semianalog/mod12003/README.txt

MOD12003  [[WIP]]
=================

Work in progress.

20V 3A power supply module for MOD1 series of modular power supplies.
