semianalog/mod12003/doc/main.pdf

OWNER’S AND SERVICE MANUAL | MOD12003

e MOD12003 is a standard-precision, 20 V, 3 A module for the MOD1 series of multi-output, modular power supplies. It uses a hybrid switching + linear architecture that achieves acceptable noise levels for most uses while also maintaining low power dissipation.

Table 1: Specications

Parameter | Value | Unit

Voltage

Full-scale output voltage | 20 | V
Output voltage resolution | 10 | mV
Output voltage tolerance | 0.5% ± 10 | mV
Minimum output-enabled voltage | 100 | mV

Current

Full-scale output current | 3 | A
Output current resolution | 2 | mA
Output current tolerance | 0.5% ± 2 | mA
Min. current limit, worst case | 10 | mA
Current sense dead zone, worst case | 0 – 10 | mA

Slew rate (soware programmable)

Max. rising slew rate (allow 2% + 15 mV overshoot) | 3.2 | V/ms
Max. rising slew rate (no overshoot) | 2.0 | V/ms
Falling slew time constant (rst-order RC) | 200 | ms

Overload

Max. forced pos. output voltage (passive) | 24 | V
Max. forced pos. output voltage (fuse blows) | 63 | V
Max. forced neg. output voltage (passive) | −0.3 | V
Max. forced neg. output voltage (fuse blows) | −63 | V
Fuse rupture capacity | 50 | A
On-board spare fuses (install with solder bridge) | 2
Programmable OVP (blows fuse if necessary) | 3 – 24 | V
OVP threshold resolution | 150 | mV
OVP threshold tolerance | 2% ± 50 | mV
z. No copyright claimed; Creative Commons Zero (https://creativecommons.org/publicdomain/zero/1.0/) where not possible. Wrien in 2015 by Chris Pavlina.

# Contents

Contents | i
1 eory of Operation | 1
A Full Schematics | 5
B MOD1 loop interface | 12
C License | 13

i

# List of Figures

1.1 | Block diagram | | 2
1.2 | Linear regulator partial: control amplier | | 3
1.3 | Linear regulator partial: output amplier | | 3
1.4 | Voltage sense amplier | | 3
1.5 | Current sense amplier | | 3
1.6 | Output protection | | 4

# List of Tables

1 | Specications | | i

ii

# Chapter 1

# eory of Operation

### 1.1 Introduction

is chapter describes the operation of the MOD12003 , ranging from a broad overview to detailed sections on subcircuits and soware routines.

Block Diagram

Figure 1.1 contains a block diagram of the MOD12003 .

e MOD12003 uses a standard, high-side regulation architecture. A 24 V input passes through an input protection block (including reverse polarity blocking and inrush current limiting / bulk capacitance isolation) and directly into a soware-controlled buck converter. e output of this converter then passes through a linear regulator stage and to the output. e output voltage is sensed directly at the output connector and passes back to both the linear regulator and the microcontroller.

e output is fused, protecting internal circuitry in the event that power is applied to the outputs externally, and helping to minimize damage to both the MOD12003 and to the device to which power is being supplied if the MOD12003 fails.

e standard MOD1 serial loop interface feeds a capacitive coupler and is processed directly by the microcontroller; passthrough to downstream modules is also handled in soware.

### 1.2 Detailed Description

Microcontroller

e Microcontroller is the device in control of the entire system. It receives signals from the MOD1 motherboard, storing the desired output voltage, current, and slew rate. ese, combined with stored calibration data, are used to choose setpoints for both the Preregulator and the Linear Regulator. Status signals from these circuits, including the output voltage and current, regulation mode, and heat sink temperature, are monitored. ese all provide feedback for multiple safety and limiting functions.

Calibration

ere are two major sources of error that must be corrected; calibration accounts for the rst one. is is manufacturing tolerance in the voltage sense and current sense ampliers and in the system voltage reference, which could cause the supply to read its own outputs incorrectly and deliver an erroneous level.

To perform adjustment, the Microcontroller congures the regulators for four test points: approximately 10% and 90% of full scale for both current and voltage. ese initial setpoints need not be correct. Aer they have stabilized, both the Microcontroller and a human operator individually measure the actually achieved value, and the operator-supplied measurement is entered into the system. ese points are used to apply a linear correction to the data read by the Analog-Digital Converter.

Voltage Control Loop

e second major source of error is inaccuracy and dri in the Linear Regulator. e error ampliers in this are not required to be accurate initially or in the long term. As such, they may have signicant oset voltage, and this oset voltage may change signicantly over temperature variants and time.

is error is removed by a self-correcting control loop implemented in the Microcontroller. e Analog-Digital Converter digitizes the signals from the Sense Ampliers, and calibration is applied. e corrected value of the output voltage is compared to the desired output voltage, and this error serves as the input to a control loop that corrects the error.

Because this error source is slow, this control loop is designed to be slow and gentle to avoid loop stability in-

1

CHAPTER 1. THEORY OF OPERATION | 2

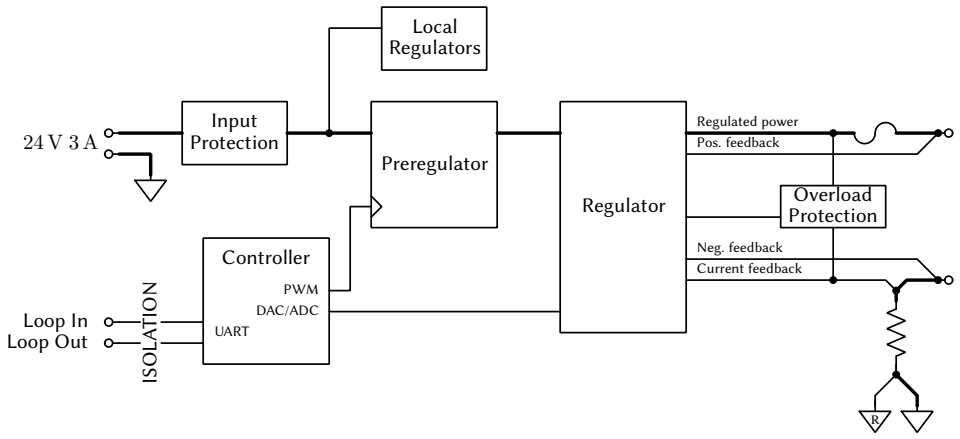
[picture p1: figure]
Input Protection; Local Regulators; Preregulator; Regulator; Loop In Loop Out; ISOLATION; Regulated power; Pos. feedback; Neg. feedback; Current feedback; Overload Protection; Controller; PWM DAC/ADC; UART

Figure 1.1: Block diagram

teractions between it and the tighter, faster loops of the Linear Regulator.

e use of such a correcting loop is a decision that was made to reduce complexity and expense in the hardware of the Linear Regulator. Because the required connections and peripherals in the Microcontroller were already in use, the Voltage Control Loop could be added at the cost of only a few lines of rmware code, allowing the error amplier in the Linear Regulator to consist of only two very modest operational ampliers.

Overvoltage Protection

e MOD12003 ’s overvoltage protection is a system involving two control methods. At its heart is a thyristor connected across the supply outputs. Current supplied to the thyristor’s gate bias circuit will cause it to latch closed-circuit, conducting current until the output fuse opens.

A comparator is constantly comparing the output voltage, as read by the Sense Amplier, to a reference signal. is reference signal is supplied by the Microcontroller as a pulse width modulated (PWM) waveform and ltered to produce a xed level. If at any moment the output voltage exceeds this point, the comparator alternates, saturating a transistor that drives the thyristor’s gate into conduction.

Due to the inaccurate nature of the PWM-derived level, this analog method is only used for fast reponse and as a last resort if the Microcontroller stops functioning 1 .
More accurate protection is provided by the Microcon-

1e PWM signal is generated by a relatively isolated peripheral inside the Microcontroller, which is expected to continue operation in the event of soware errors or freezes.

troller rmware. If the output voltage is detected beyond a narrow margin above the setpoint, the PWM signal will saturate, quickly forcing the thyristor into conduction regardless of the output voltage as seen by the comparator.

Group Error Response

In an environment where multiple supply modules are used to power multiple rails of a single device, it may be desirable to have so-called Group Error Response. e Microcontroller detects multiple error conditions, including overvoltage protection trip, output current exceeding a set value (if desired, with a xed grace period to allow inrush currents), thermal overload, and oscillation of the Linear Regulator. If Group Error Response is congured, the selected error conditions will cause the Microcontroller to notify all the other modules in the MOD1 system, prompting the entire system to shut down as a precaution.

Preregulator

To allow substantial amounts of power to be delivered by a relatively small supply module, a relatively higheciency buck-mode DC-DC converter is employed. is is controlled by a pulse-width modulated waveform from the Microcontroller. An amplier translates and shis the signal to provide a 0 V to −14 V (relative to the positive supply) gate drive waveform to a power P-channel MOS-FET. e MOSFET, in conjunction with a Schoky diode, chops the supply into a square wave which is then ltered by an LC lter circuit.

Soware control allows the Preregulator to be controlled in a way that is most suitable for a hybrid power supply. Under higher power conditions, the voltage drop across the Linear Regulator will be minimized to keep its

CHAPTER 1. THEORY OF OPERATION | 3

−

+

−

+

Voltage
Feedback

Voltage
Setpoint

Current

Current

Feedback

Setpoint

To
Output
Amplifier

U2B

U2A

D3

Figure 1.2: Linear regulator partial: control amplier

temperature low. Only a small amount of voltage ‘headroom’ is required to maintain an acceptable transient response. However, this is not optimal under lower power conditions. e regulator would switch into ‘discontinuous’ mode, meaning that the MOSFET and diode are not always conducting. ere is a dead time during which output current is supplied only by the lter capacitors. is increases output voltage ripple and high-frequency noise (the laer due to the ringing that is usually present in the system when the normally driven ‘switching node’ becomes a high impedance). When the output power level is low enough for this to happen, it will also be low enough for the Linear Regulator to provide all regulation by itself, and so the Microcontroller will simply switch the MOSFET ‘on’ and allow the full input voltage to reach the Linear Regulator.

Linear Regulator

Despite the eciency benet of the buck converter, it is not ideal. A switching converter’s output has a large amount of voltage ripple and it does not have a particularly nice transient response. To convert the output of the Preregulator into a suciently clean supply, a Linear Regulator passes and regulates the supply.

Control Ampliers

Figure 1.2 shows a simplied, partial schematic of the control amplier. Operational amplier U2B compares the voltage setpoint to the voltage feedback, driving the output amplier through switching diode pair D3. Likewise, operational amplier U2A compares the current setpoint to the current feedback, also driving the output amplier through D3. e switching diode pair ensures that the output amplier is driven by whichever of the two control ampliers is producing the smaller signal, allowing either amplier to ‘limit’ the other.

Power
Input

Power
Output

Control

From

Amplifier

Q10

Q12

Q11

D4

R33

E1 R31

R30

Figure 1.3: Linear regulator partial: output amplier

−

+

R

Sense−

Sense+

Out

R15

R16

R19

R20

U1B

Figure 1.4: Voltage sense amplier

−

+

R

Current

Out

U1A

R22 | R21

R18

R3

Figure 1.5: Current sense amplier

Output Amplier

Figure 1.3 shows a simplied schematic of the output amplier. Q10 and Q12 form a complementary feedback pair to supply the output current, and two ferrite beads stabilize the pair against layout-induced oscillation. Q11 buers the output signal further to ensure that even when manufacturing variations give low current gain in the Q10, a relatively high resistor can supply the bias to the output amplier.

Diode pair D4 protects the emier-base junctions of Q11 and Q12 in the case that the output voltage is externally forced above the setpoint.

CHAPTER 1. THEORY OF OPERATION | 4

From
Output
Amplifier

Thyristor
Trip
To Current
Sense

Output+

Output−

Q2 | D1

F1

Figure 1.6: Output protection

Sense Ampliers

Figure 1.4 shows a simplied schematic of the voltage sense amplier. is is a dierential amplier that translates the output voltage, as detected between the positive and negative output connectors, onto the system’s internal 0 V reference potential. is is multiplied by the gain, which in this case is below unity: 1/11. A sub-unity gain allows the relatively large output voltage to be scaled into a range that is acceptable to the Microcontroller’s analog-digital and digital-analog converters.

Figure 1.5 shows a simplied schematic of the current sense amplier. Because the system 0 V reference potential is taken directly at one side of the current sense resistor, dierential amplication is not necessary. U1A ampli-es the voltage across the sense resistor by a xed gain of 64.2 to maximize the Microcontroller-domain voltage range. A resistor in series with the amplier’s input protects it against voltage spikes that may be present in the event of a sudden output short-circuit.

Output Protection

Both the power supply and the circuit being powered can be protected from each other. A series fuse at the output makes this possible. yristor Q9 and diode D4 sit behind the fuse (see g. 1.6) and will blow this fuse under certain conditions

- If a negative voltage is applied to the output, D4 will conduct.
- If a voltage above 25 V is applied to the output, DZ1 will trip the thyristor.
- If the output voltage exceeds a sowareprogrammed threshold for any reason, U5A via Q11 will trip the thyristor.
- If the soware decides to for any other reason, typically because the output voltage has exceeded the setpoint and cannot be brought down, it will cause U5A to trip the thyristor by immediately saturating the trip point.

yristors have an internal ‘latching’ eect that causes them to remain closed-circuit once thy trip until current stops owing. When Q9 trips, it will conduct indenitely or until the fuse blows.

Input Circuit

A small amount of conditioning is applied to the input power. Transistor Q10A provides reverse-polarity protection. If power is applied with the polarity reversed, the gate-source voltage applied to Q10A will be zero, and it will not switch on. If power is applied with correct polarity, the subtrate diode of the transistor will allow current to ow. As the voltage beyond the transistor rises, the magnitude of the gate-source voltage increases, and eventually the transistor will switch totally ‘on’ and bypass the substrate diode entirely.

e input current must also pass through Q10B, which is inverted with respect to Q10A such that it can restrict the ow of forward current into the system. As Q10B begins to turn on, it must pass through its active region where it controls the output in an analog sense. At this point, it becomes an amplier, with the drain its output, the source its noninverting input, and the gate its inverting input. Capacitor C23 provides negative feedback and converts it into an integrator. is gives a linear, controlled, sloping output voltage, which slowly charges the input capacitance of the system rather than allowing a large inrush current to ow. is inrush limiting is essential, as a large inrush current can trip the current limiting feature of some power supplies that might be used as an input source.

Communications

e MOD1 series uses a loop communications interface. Each node, including the modules and the motherboard, has a UART which transmits and receives messages in standard 8N1 encoding. Each node transmits messages to the next, with the nal node returning the mssage to the rst, in a loop. In this way, an ordering of nodes is developed, such that there is no need to manually assign them indices.

For information on the message format, see appendix B.

# Appendix A

# Full Schematics

e following pages contain schematics exported directly from the CAD soware. While they are documented, it is intended that readers will rst familiarize themselves with the workings of the circuits by reading through the eory of Operation.

5

# Linear Linear.sch

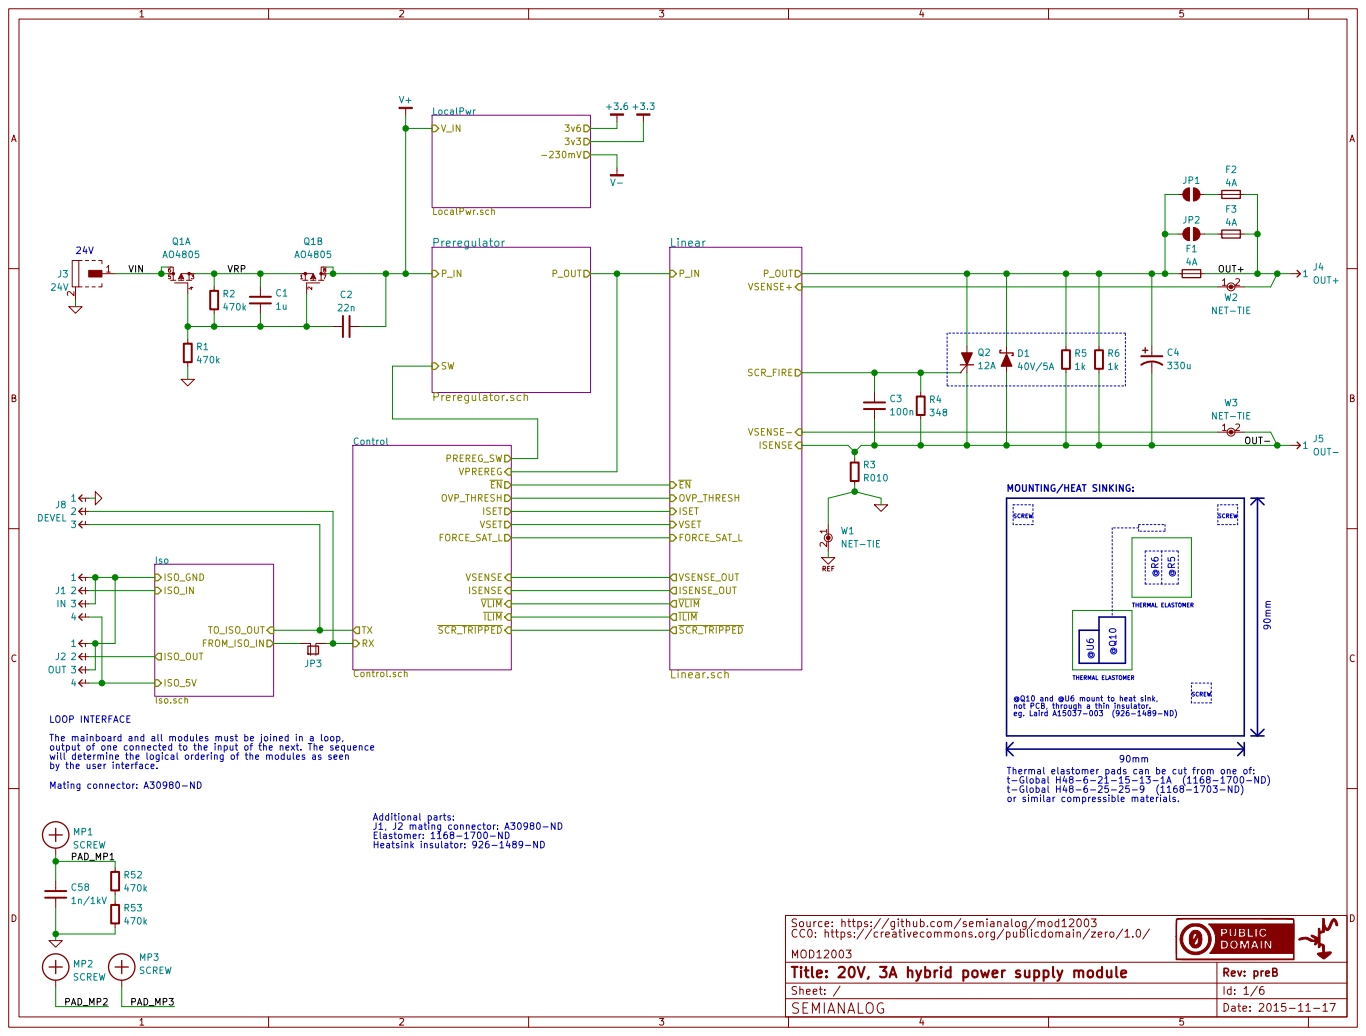
[picture p2: page 9]

@Q10 and @U6 mount to heat sink, not PCB, through a thin insulator. eg. Laird A15037-003 (926-1489-ND) @U⁶

THERMAL ELASTOMER Thermal elastomer pads can be cut from one of:

LOOP INTERFACE
The mainboard and all modules must be joined in a loop,
output of one connected to the input of the next. The sequence
will determine the logical ordering of the modules as seen
by the user interface.

Sheet: / MOD12003 Source: https://github.com/semianalog/mod12003
CC0: https://creativecommons.org/publicdomain/zero/1.0/

Id: 1/6 Title: 20V, 3A hybrid power supply module

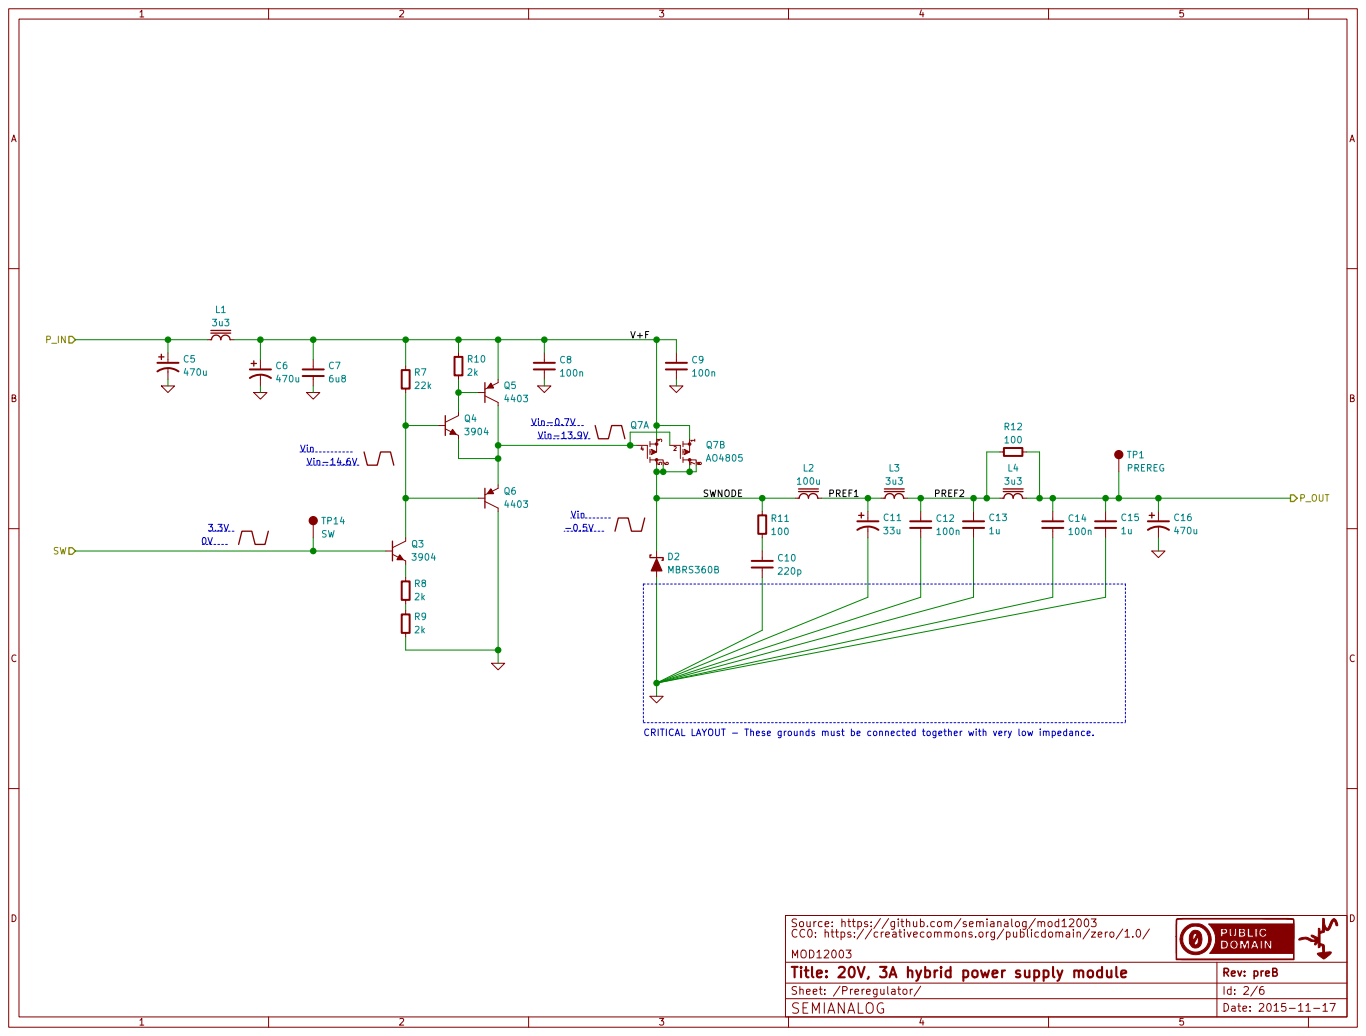
[picture p3: page 10]

1u CRITICAL LAYOUT - These grounds must be connected together with very low impedance. L3

Sheet: /Preregulator/ MOD12003 Source: https://github.com/semianalog/mod12003
CC0: https://creativecommons.org/publicdomain/zero/1.0/

Id: 2/6 Title: 20V, 3A hybrid power supply module

# OVP_THRESH V⁻ 4 V⁺

470k C30

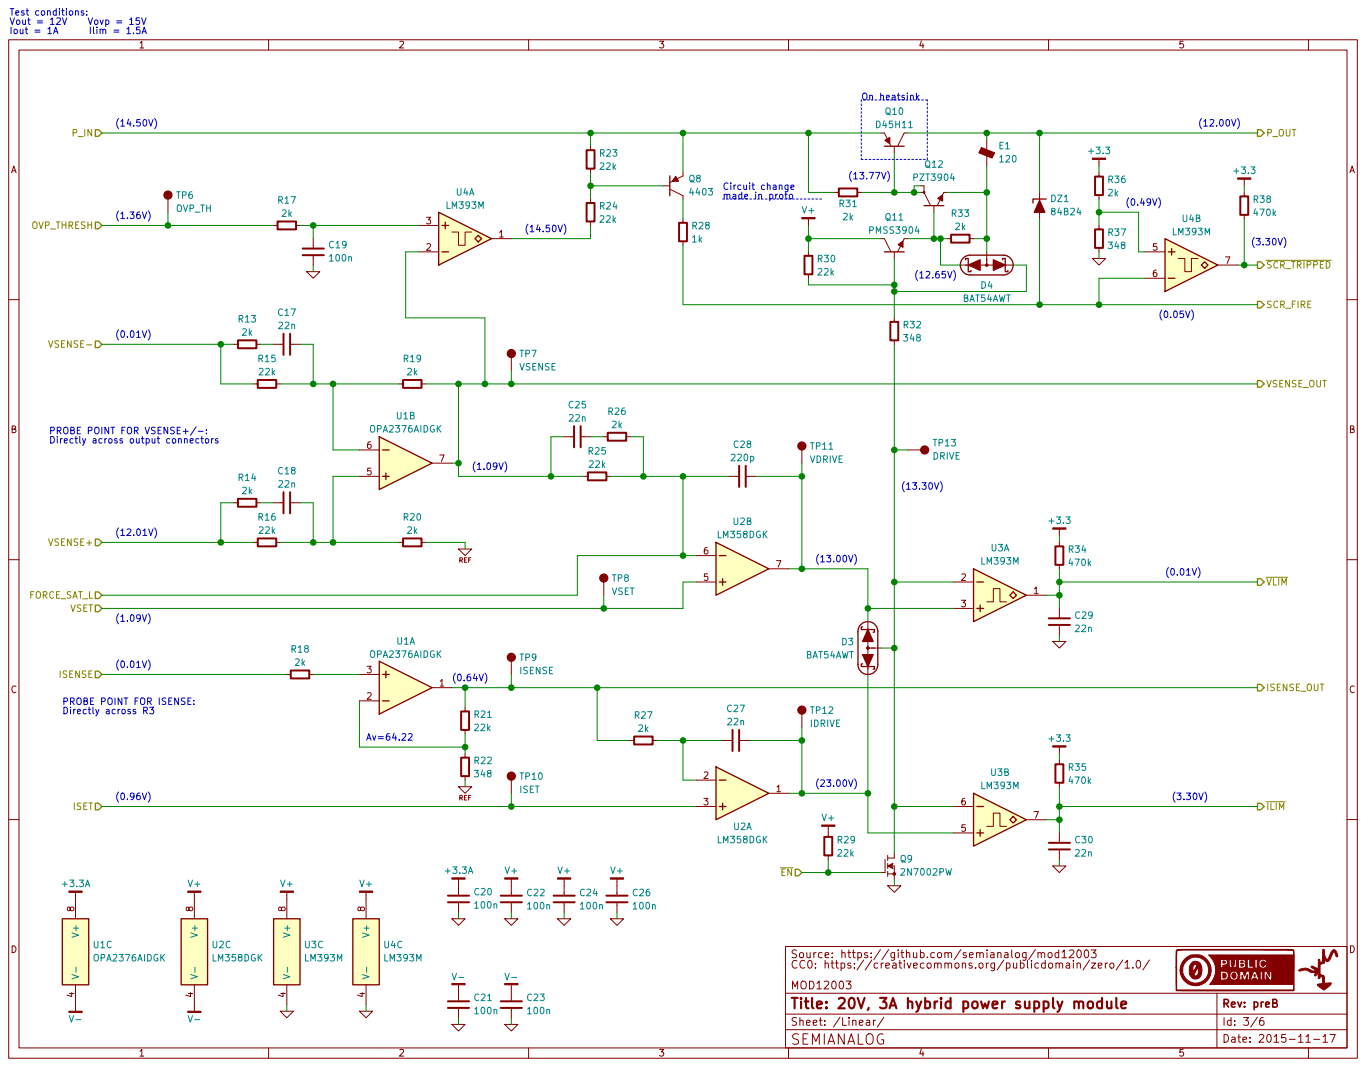
[picture p4: page 11]

120 Test conditions: Vout = 12V Vovp = 15V

22k FORCE_SAT_L FORCE_SAT_L does not exist on the PCB;

Sheet: /Linear/ MOD12003 Source: https://github.com/semianalog/mod12003
CC0: https://creativecommons.org/publicdomain/zero/1.0/

Id: 3/6 Title: 20V, 3A hybrid power supply module

# VREF GND

100n C38

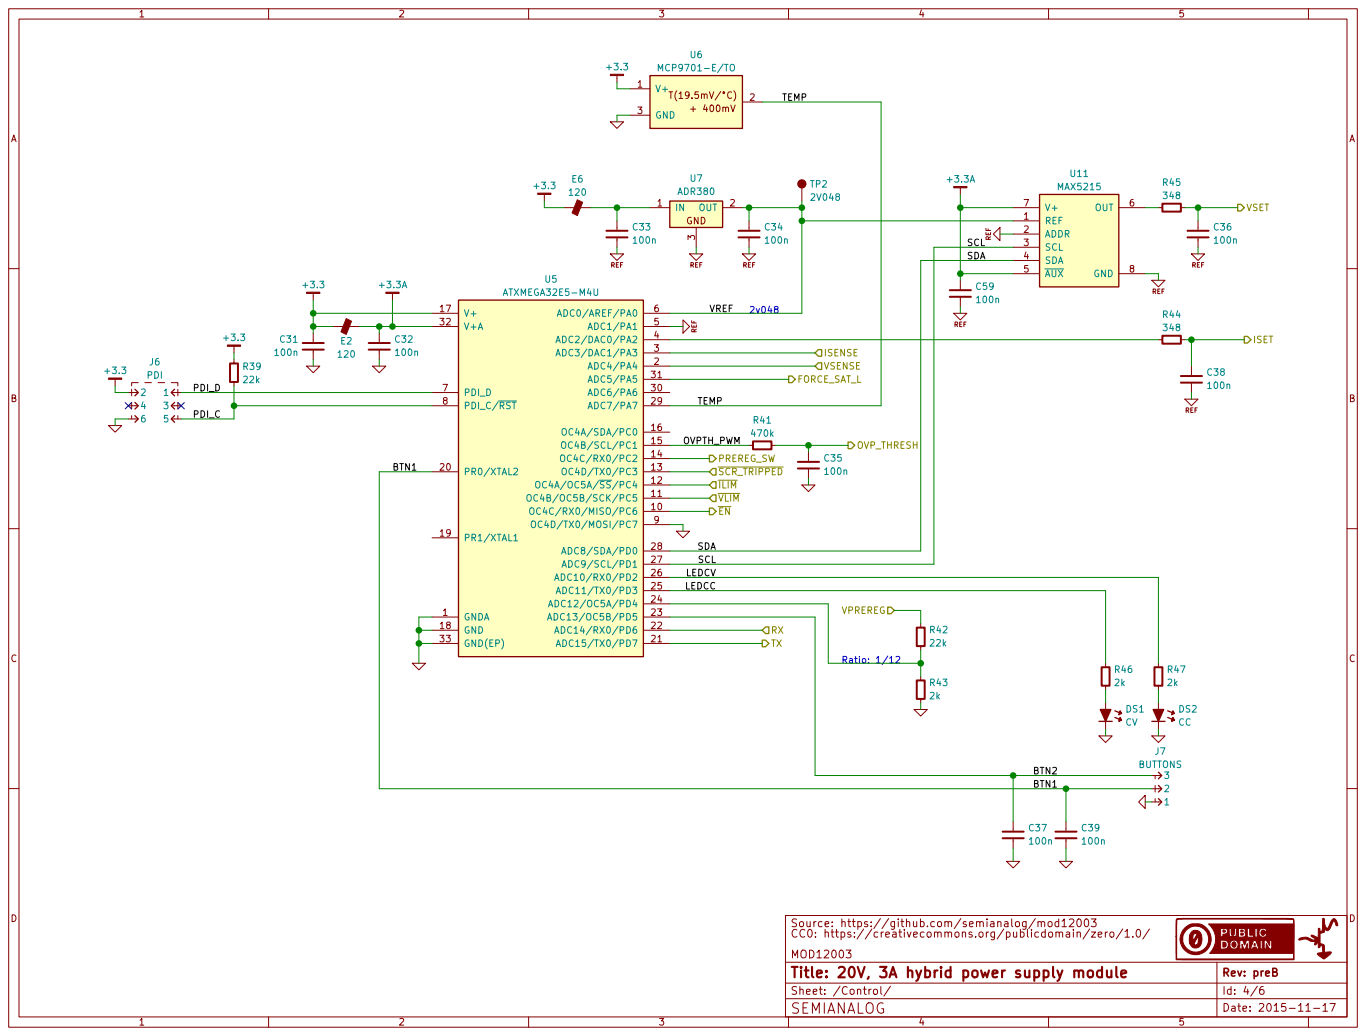
[picture p5: page 12]

Sheet: /Control/ MOD12003 Source: https://github.com/semianalog/mod12003
CC0: https://creativecommons.org/publicdomain/zero/1.0/

Id: 4/6 Title: 20V, 3A hybrid power supply module

120 E3

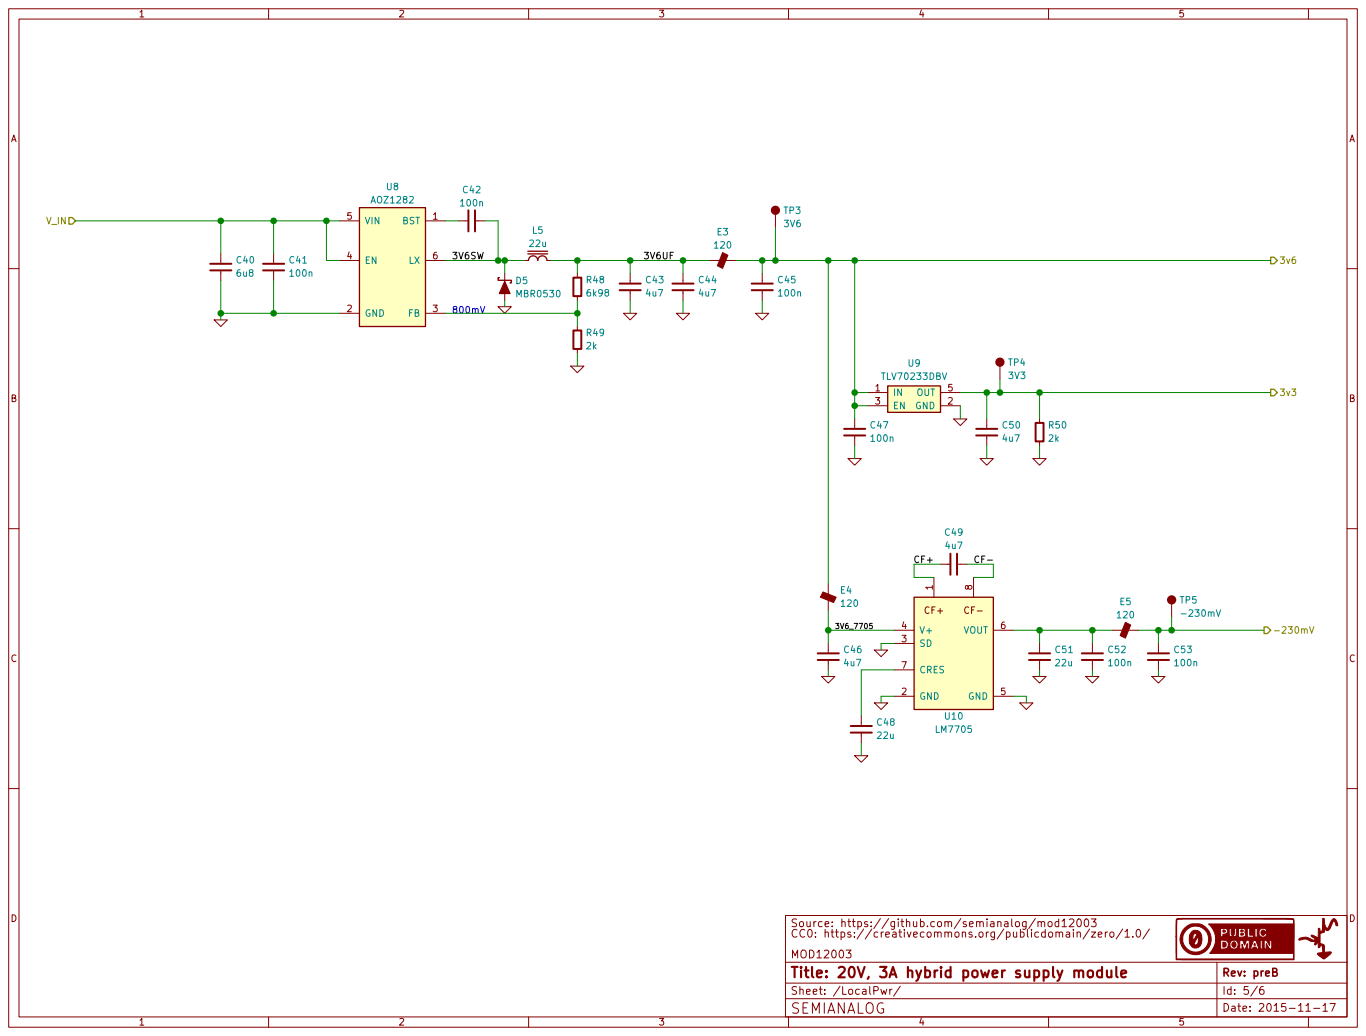
[picture p6: page 13]

Sheet: /LocalPwr/ MOD12003 Source: https://github.com/semianalog/mod12003
CC0: https://creativecommons.org/publicdomain/zero/1.0/

Id: 5/6 Title: 20V, 3A hybrid power supply module

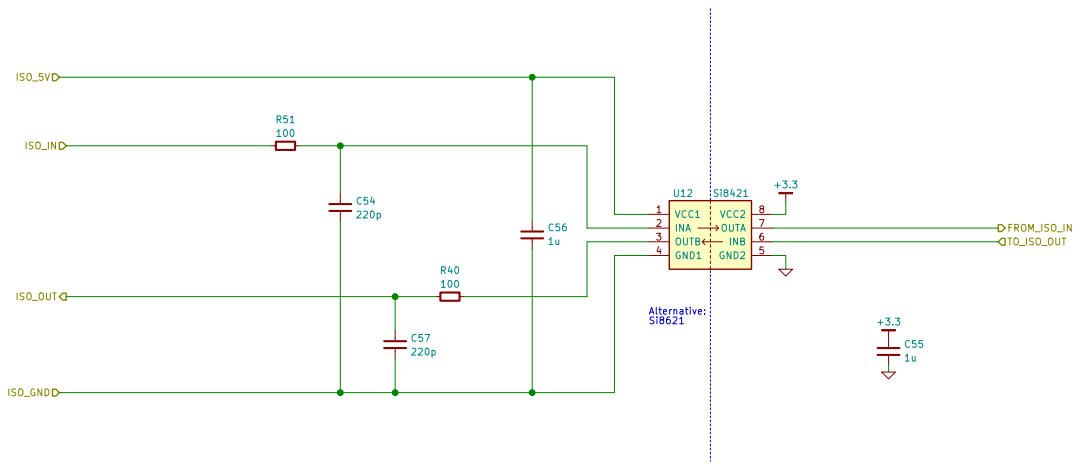
[picture p7: page 14]
D SEMIANALOG; Date: 2015-11-17 Rev: preB; ISO_5V; ISO_GND; TO_ISO_OUT; FROM_ISO_IN; ISO_IN; ISO_OUT; +3.3 VCC1; INA; 2 OUTB 3 GND1; GND2; INB; 6 OUTA; 7 VCC2; +3.3 Alternative: Si8621 C56

Sheet: /Iso/ MOD12003 Source: https://github.com/semianalog/mod12003
CC0: https://creativecommons.org/publicdomain/zero/1.0/

Id: 6/6 Title: 20V, 3A hybrid power supply module

# Appendix B

# MOD1 loop interface

12

# Appendix C

# License

e MOD12003 is open hardware under the Creative Commons CC0 license version 1.0 Universal.

### C.1 CC0 1.0 Universal

CREATIVE COMMONS CORPORATION IS NOT A LAW FIRM AND DOES NOT PROVIDE LEGAL SER-VICES. DISTRIBUTION OF THIS DOCUMENT DOES NOT CREATE AN ATTORNEY-CLIENT RELATION-SHIP. CREATIVE COMMONS PROVIDES THIS INFORMATION ON AN “AS-IS” BASIS. CREATIVE COM-MONS MAKES NO WARRANTIES REGARDING THE USE OF THIS DOCUMENT OR THE INFORMATION OR WORKS PROVIDED HEREUNDER, AND DISCLAIMS LIABILITY FOR DAMAGES RESULTING FROM THE USE OF THIS DOCUMENT OR THE INFORMATION OR WORKS PROVIDED HEREUNDER.

### Statement of Purpose

e laws of most jurisdictions throughout the world automatically confer exclusive Copyright and Related Rights (dened below) upon the creator and subsequent owner(s) (each and all, an “owner”) of an original work of authorship and/or a database (each, a “Work”).

Certain owners wish to permanently relinquish those rights to a Work for the purpose of contributing to a commons of creative, cultural and scientic works (“Commons”) that the public can reliably and without fear of later claims of infringement build upon, modify, incorporate in other works, reuse and redistribute as freely as possible in any form whatsoever and for any purposes, including without limitation commercial purposes. ese owners may contribute to the Commons to promote the ideal of a free culture and the further production of creative, cultural and scientic works, or to gain reputation or greater distribution for their Work in part through the use and eorts of others.

For these and/or other purposes and motivations, and without any expectation of additional consideration or compensation, the person associating CC0 with a Work (the “Armer”), to the extent that he or she is an owner of Copyright and Related Rights in the Work, voluntarily elects to apply CC0 to the Work and publicly distribute the Work under its terms, with knowledge of his or her Copyright and Related Rights in the Work and the meaning and intended legal eect of CC0 on those rights.

1. Copyright and Related Rights. A Work made available under CC0 may be protected by copyright and related or neighboring rights (“Copyright and Related Rights”). Copyright and Related Rights include, but are not limited to, the following:
i. the right to reproduce, adapt, distribute, perform, display, communicate, and translate a Work;

ii. moral rights retained by the original author(s) and/or performer(s);

iii. publicity and privacy rights pertaining to a person’s image or likeness depicted in a Work;

13

APPENDIX C. LICENSE | 14

iv. rights protecting against unfair competition in regards to a Work, subject to the limitations in paragraph 4(a), below;

v. rights protecting the extraction, dissemination, use and reuse of data in a Work;

vi. database rights (such as those arising under Directive 96/9/EC of the European Parliament and of the Council of 11 March 1996 on the legal protection of databases, and under any national implementation thereof, including any amended or successor version of such directive); and

vii. other similar, equivalent or corresponding rights throughout the world based on applicable law or treaty, and any national implementations thereof.

2. Waiver. To the greatest extent permied by, but not in contravention of, applicable law, Armer hereby overtly, fully, permanently, irrevocably and unconditionally waives, abandons, and surrenders all of Armer’s Copyright and Related Rights and associated claims and causes of action, whether now known or unknown (including existing as well as future claims and causes of action), in the Work (i) in all territories worldwide, (ii) for the maximum duration provided by applicable law or treaty (including future time extensions), (iii) in any current or future medium and for any number of copies, and (iv) for any purpose whatsoever, including without limitation commercial, advertising or promotional purposes (the “Waiver”). Armer makes the Waiver for the benet of each member of the public at large and to the detriment of Armer’s heirs and successors, fully intending that such Waiver shall not be subject to revocation, rescission, cancellation, termination, or any other legal or equitable action to disrupt the quiet enjoyment of the Work by the public as contemplated by Armer’s express Statement of Purpose.
3. Public License Fallback. Should any part of the Waiver for any reason be judged legally invalid or ineective under applicable law, then the Waiver shall be preserved to the maximum extent permied taking into account Armer’s express Statement of Purpose. In addition, to the extent the Waiver is so judged Armer hereby grants to each aected person a royalty-free, non transferable, non sublicensable, non exclusive, irrevocable and unconditional license to exercise Armer’s Copyright and Related Rights in the Work (i) in all territories worldwide, (ii) for the maximum duration provided by applicable law or treaty (including future time extensions), (iii) in any current or future medium and for any number of copies, and (iv) for any purpose whatsoever, including without limitation commercial, advertising or promotional purposes (the “License”). e License shall be deemed eective as of the date CC0 was applied by Armer to the Work. Should any part of the License for any reason be judged legally invalid or ineective under applicable law, such partial invalidity or ineectiveness shall not invalidate the remainder of the License, and in such case Armer hereby arms that he or she will not (i) exercise any of his or her remaining Copyright and Related Rights in the Work or (ii) assert any associated claims and causes of action with respect to the Work, in either case contrary to Armer’s express Statement of Purpose.
4. Limitations and Disclaimers.
a. No trademark or patent rights held by Armer are waived, abandoned, surrendered, licensed or otherwise aected by this document.
b. Armer oers the Work as-is and makes no representations or warranties of any kind concerning the Work, express, implied, statutory or otherwise, including without limitation warranties of title, merchantability, tness for a particular purpose, non infringement, or the absence of latent or other defects, accuracy, or the present or absence of errors, whether or not discoverable, all to the greatest extent permissible under applicable law.
c. Armer disclaims responsibility for clearing rights of other persons that may apply to the Work or any use thereof, including without limitation any person’s Copyright and Related Rights in the Work. Further, Armer disclaims responsibility for obtaining any necessary consents, permissions or other rights required for any use of the Work.
d. Armer understands and acknowledges that Creative Commons is not a party to this document and has no duty or obligation with respect to this CC0 or use of the Work.
