semianalog/mod12003/mod12003.pdf

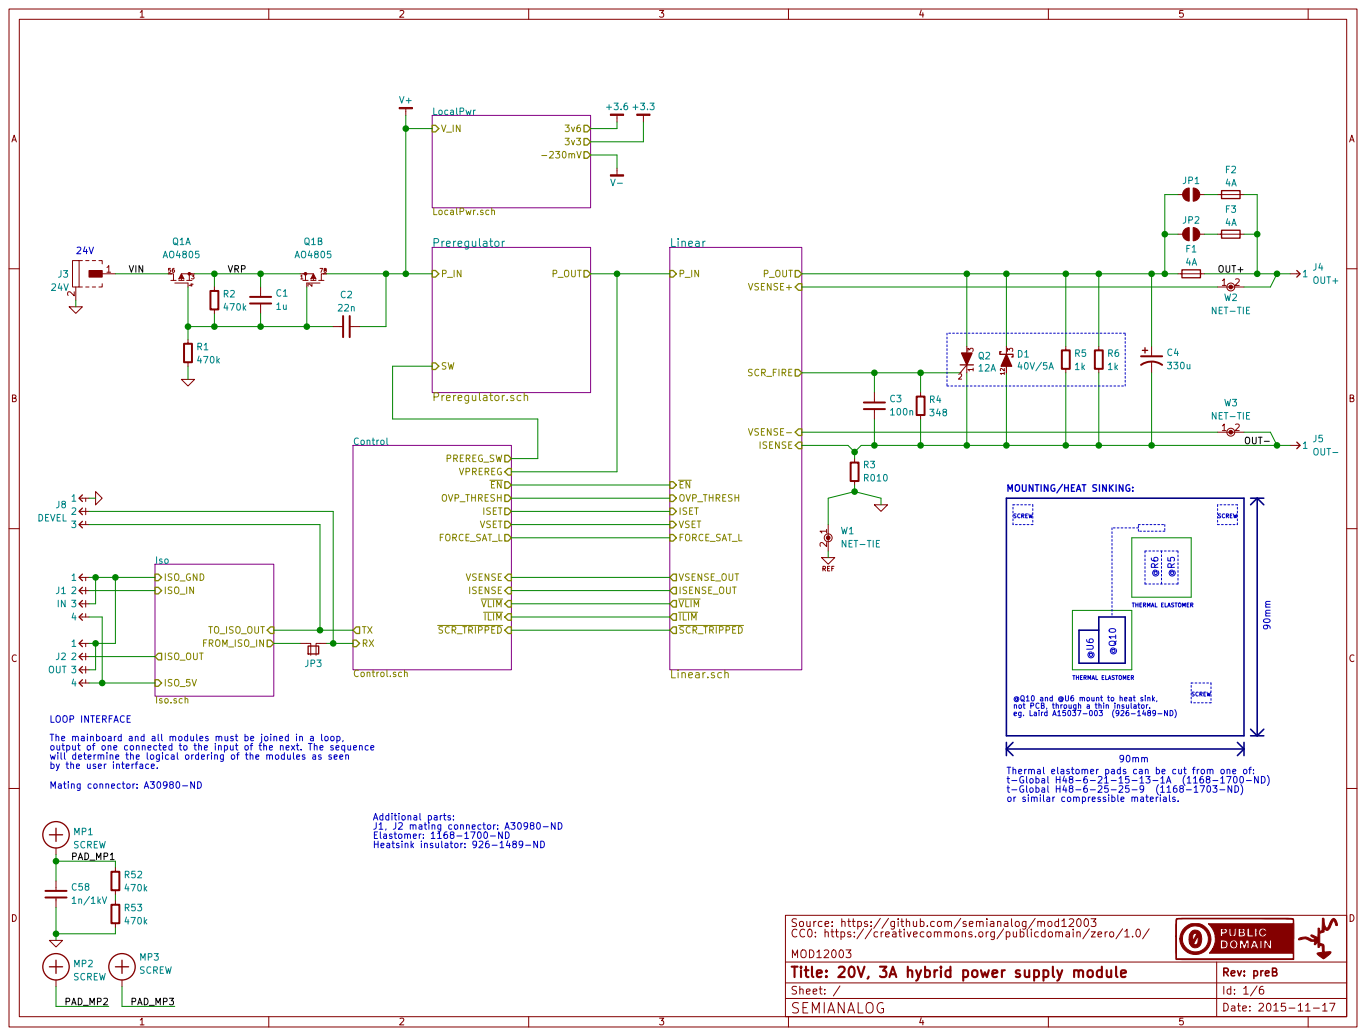
[picture p8: page 1]

@Q10 and @U6 mount to heat sink, not PCB, through a thin insulator. eg. Laird A15037-003 (926-1489-ND) @U6

THERMAL ELASTOMER Thermal elastomer pads can be cut from one of:

LOOP INTERFACE
The mainboard and all modules must be joined in a loop,
output of one connected to the input of the next. The sequence
will determine the logical ordering of the modules as seen
by the user interface.

Sheet: / MOD12003 Source: https://github.com/semianalog/mod12003 CC0: https://creativecommons.org/publicdomain/zero/1.0/

Id: 1/6 Title: 20V, 3A hybrid power supply module

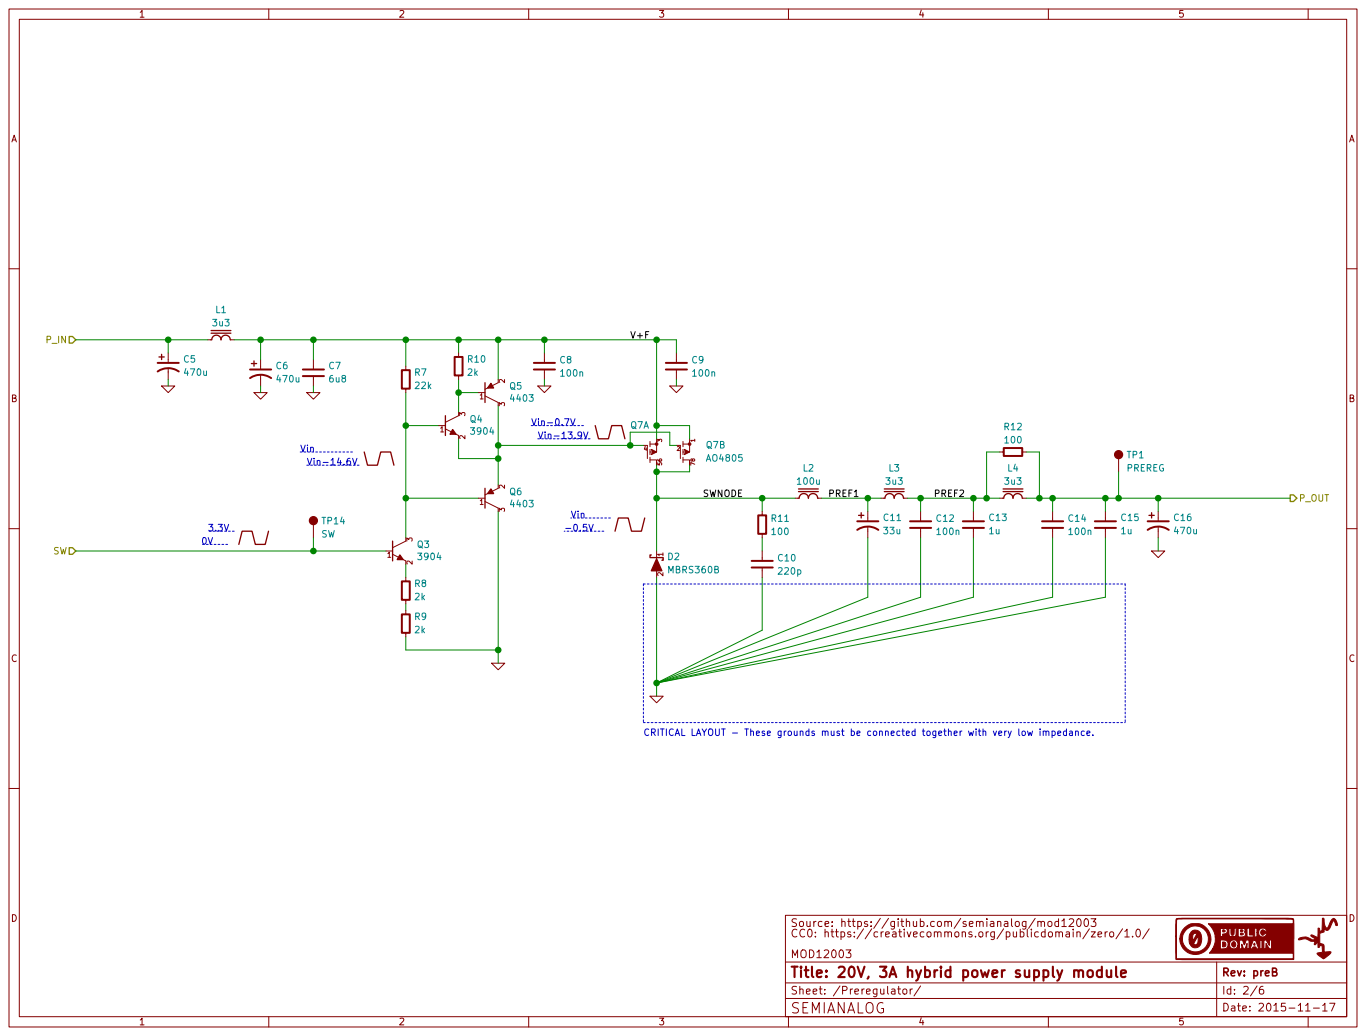
[picture p9: page 2]

1u CRITICAL LAYOUT - These grounds must be connected together with very low impedance. L3

Sheet: /Preregulator/ MOD12003 Source: https://github.com/semianalog/mod12003 CC0: https://creativecommons.org/publicdomain/zero/1.0/

Id: 2/6 Title: 20V, 3A hybrid power supply module

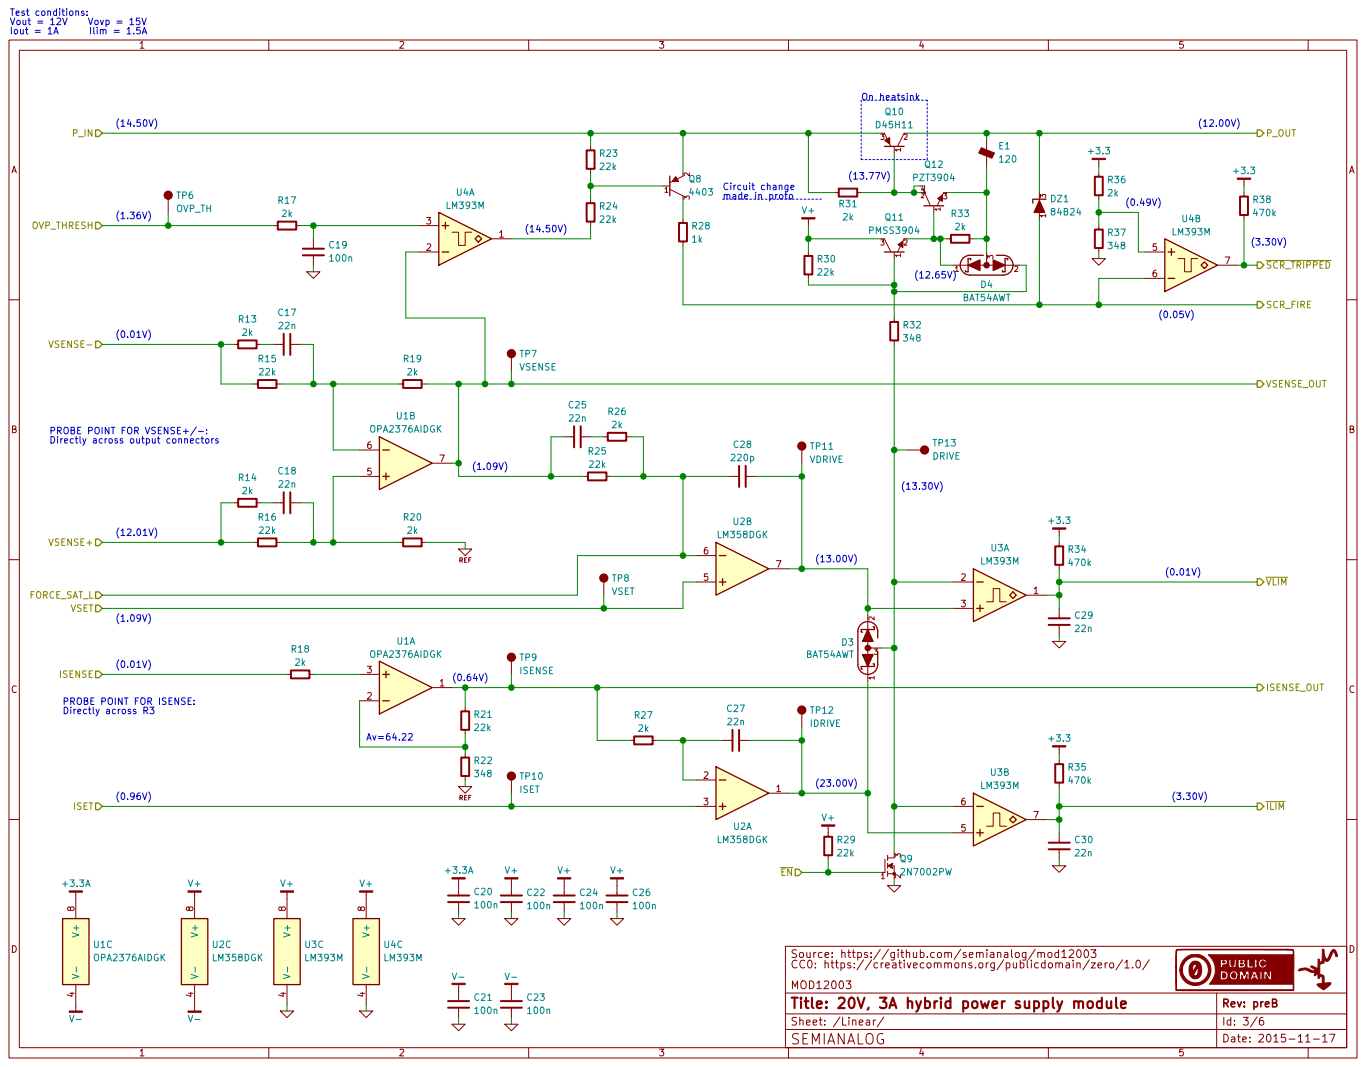
[picture p10: page 3]

120 Test conditions: Vout = 12V Vovp = 15V

22k FORCE_SAT_L FORCE_SAT_L does not exist on the PCB;

Sheet: /Linear/ MOD12003 Source: https://github.com/semianalog/mod12003 CC0: https://creativecommons.org/publicdomain/zero/1.0/

Id: 3/6 Title: 20V, 3A hybrid power supply module

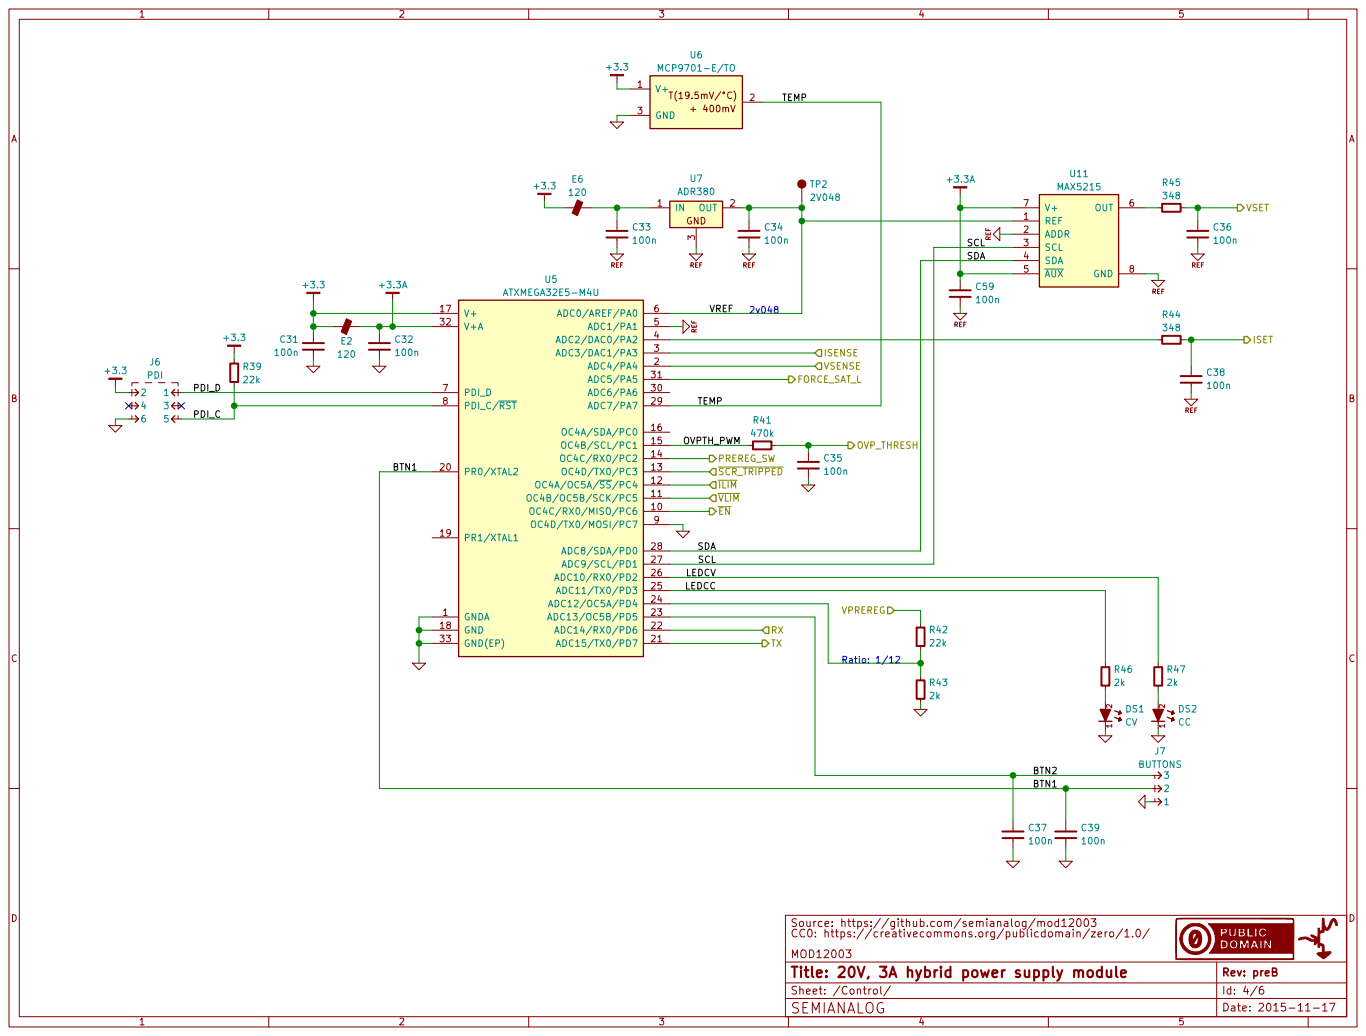
[picture p11: page 4]

Sheet: /Control/ MOD12003 Source: https://github.com/semianalog/mod12003 CC0: https://creativecommons.org/publicdomain/zero/1.0/

Id: 4/6 Title: 20V, 3A hybrid power supply module

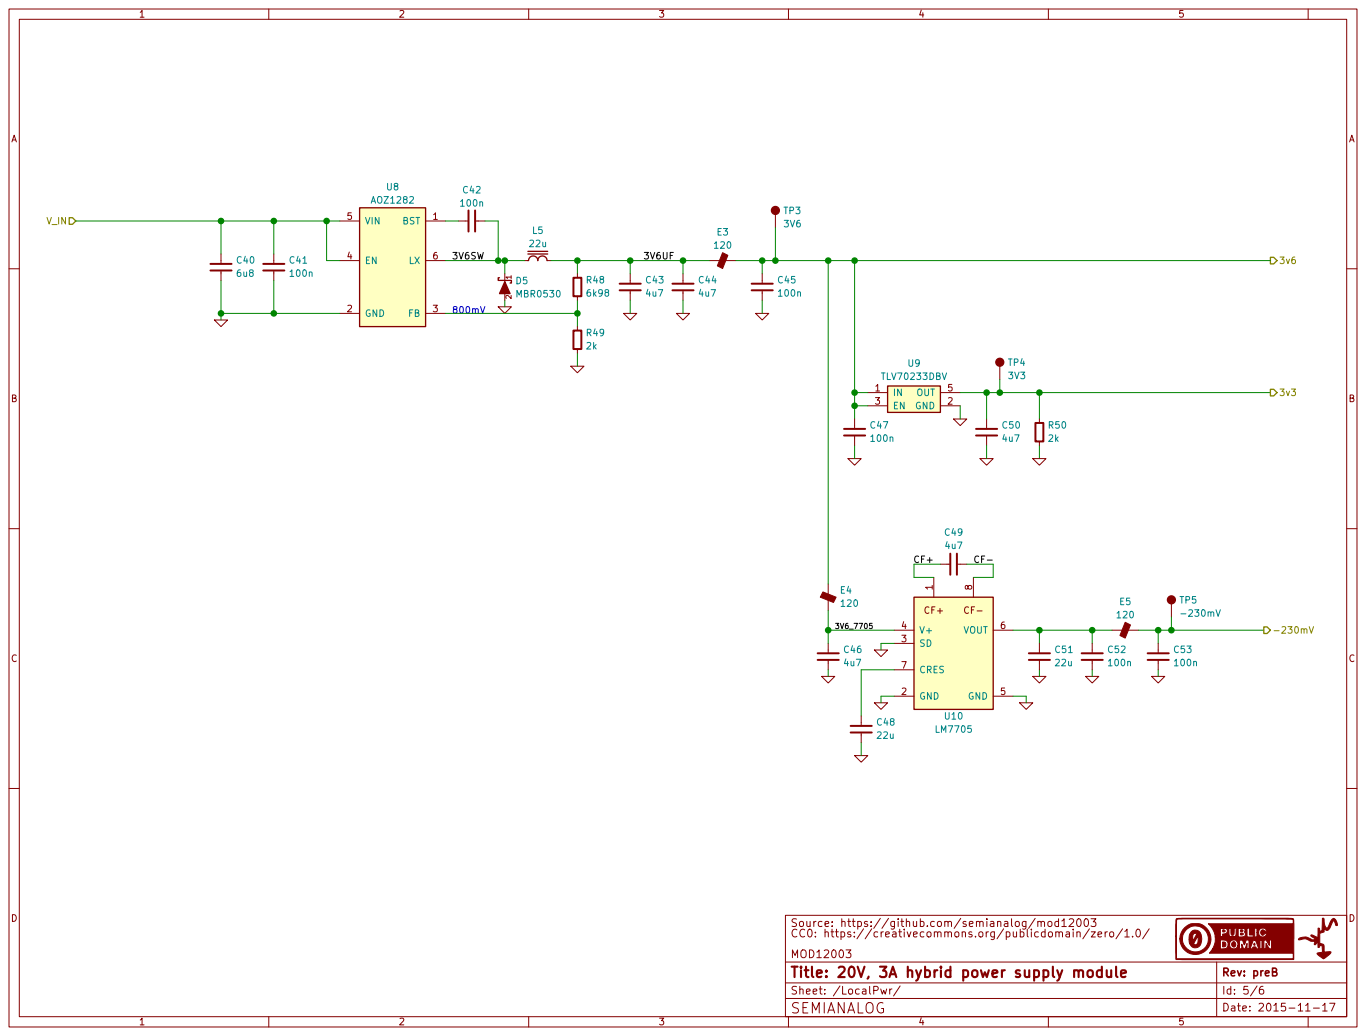
[picture p12: page 5]

Sheet: /LocalPwr/ MOD12003 Source: https://github.com/semianalog/mod12003 CC0: https://creativecommons.org/publicdomain/zero/1.0/

Id: 5/6 Title: 20V, 3A hybrid power supply module

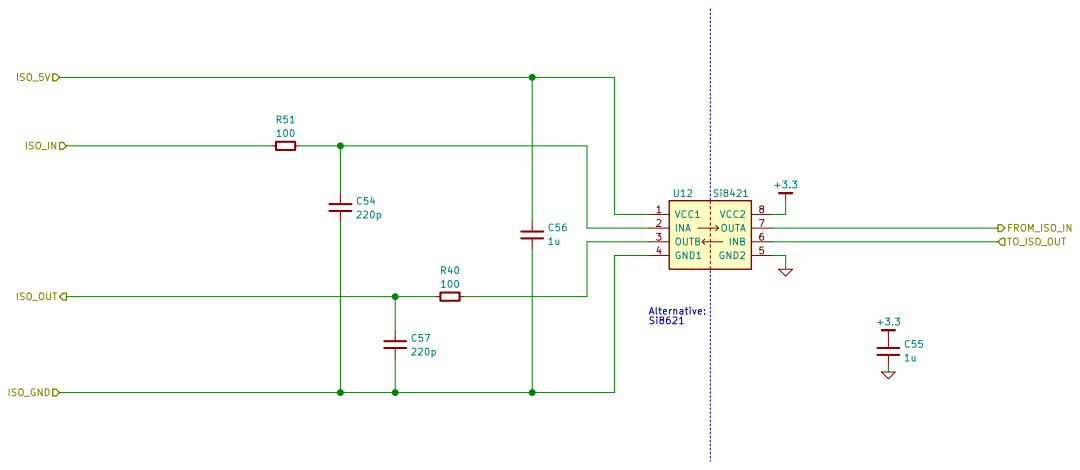
[picture p13: page 6]

Sheet: /Iso/ MOD12003 Source: https://github.com/semianalog/mod12003 CC0: https://creativecommons.org/publicdomain/zero/1.0/

Id: 6/6 Title: 20V, 3A hybrid power supply module
