semianalog/mod12003/sim/linear.asc

B1: bv; V=V(OUT+,OUT-)
B2: bi; I=-I(B1)
C1: cap; 22n
C2: cap; 22n
C3: cap; 220p
C4: cap; 22n
C5: cap; 22n
C6: cap; 330µ; Rser=.01
C7: cap; 22n
C8: cap; 22n
D1: diode; BAT54
D2: diode; BAT54
D3: zener; BZX84C12L
D4: zener; BZX84C12L
D5: diode; BAT54
D6: diode; BAT54
D7: diode
I1: load2; PULSE(0 2 0 1u 1u 0.1 0.2); load
L1: FerriteBead; 270n; Ipk=0.1 Rser=0.144 Rpar=163 Cpar=360f mfg="Wurth Elektronik" pn="742 792 711 5"
Q1: pnp; 2N4403
Q2: pnp; D45H11
Q3: npn; 2N3904
Q4: npn; 2N3904
R1: res; 2k
R2: res; 470k
R3: res; 20k
R4: res; 20k
R5: res; 1k2
R6: res; 2k
R7: res; 2k
R8: res; 20k
R9: res; 330
R10: res; 2k
R11: res; 20k
R12: res; 2k
R13: res; 2k
R14: res; 20k
R15: res; 2k
R16: res; 20k
R17: res; 2k
R18: res; 2k
R19: res; 20k
R20: res; 330
R21: res; 20k
R22: res; 2k
R23: res; 470k
R24: res; 600
R25: res; 0.01
R26: res; 330
R27: res; 470k
U1: opamp2; LM393
U2: opamp2; AD8606
U3: opamp2; LM324
U4: opamp2; LM324
U5: opamp2; AD8606
U6: opamp2; LM393
U7: opamp2; LM393
U8: opamp2; LM393
V1: voltage; 12
V2: voltage; 24
V3: voltage; 3.3
V4: voltage; -230m
V5: voltage; 2.048
V6: voltage; PULSE(0 0.1 0 1u)
V7: voltage; 2.048
V8: voltage; 0
V9: voltage; 0
V10: voltage; 0
Named nets: 0, VPREREG, V24, 3V3, V-, OVPTHR, REFG, VSENSE+, VSENSE-, VSENSE, VSET, ISET, ISENSE, OUT+, OUT-, OUT, _VLIM, _ILIM
.lib AD8606.sub
.lib LM393.sub
.lib LM324.sub
.tran 1 startup
