semianalog/mod12003/mod12003.kicad_pcb

## KiCad design mod12003.kicad_pcb (2016-01-18)

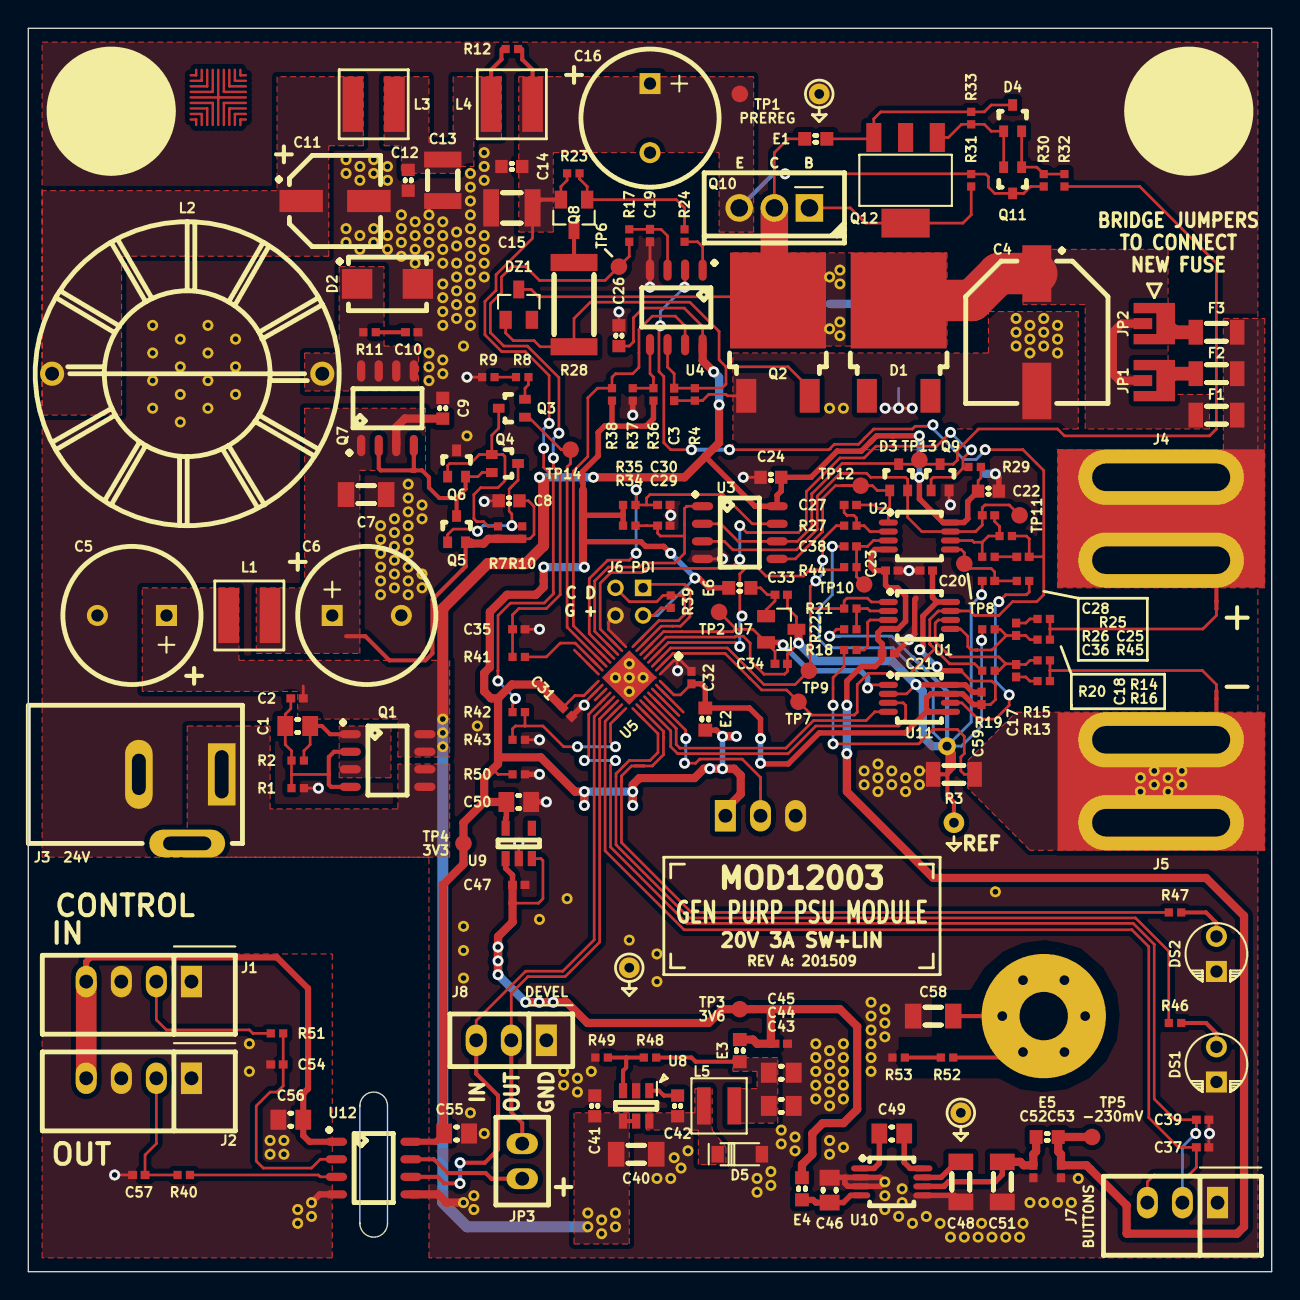
[picture p14: board mod12003.kicad_pcb from above]

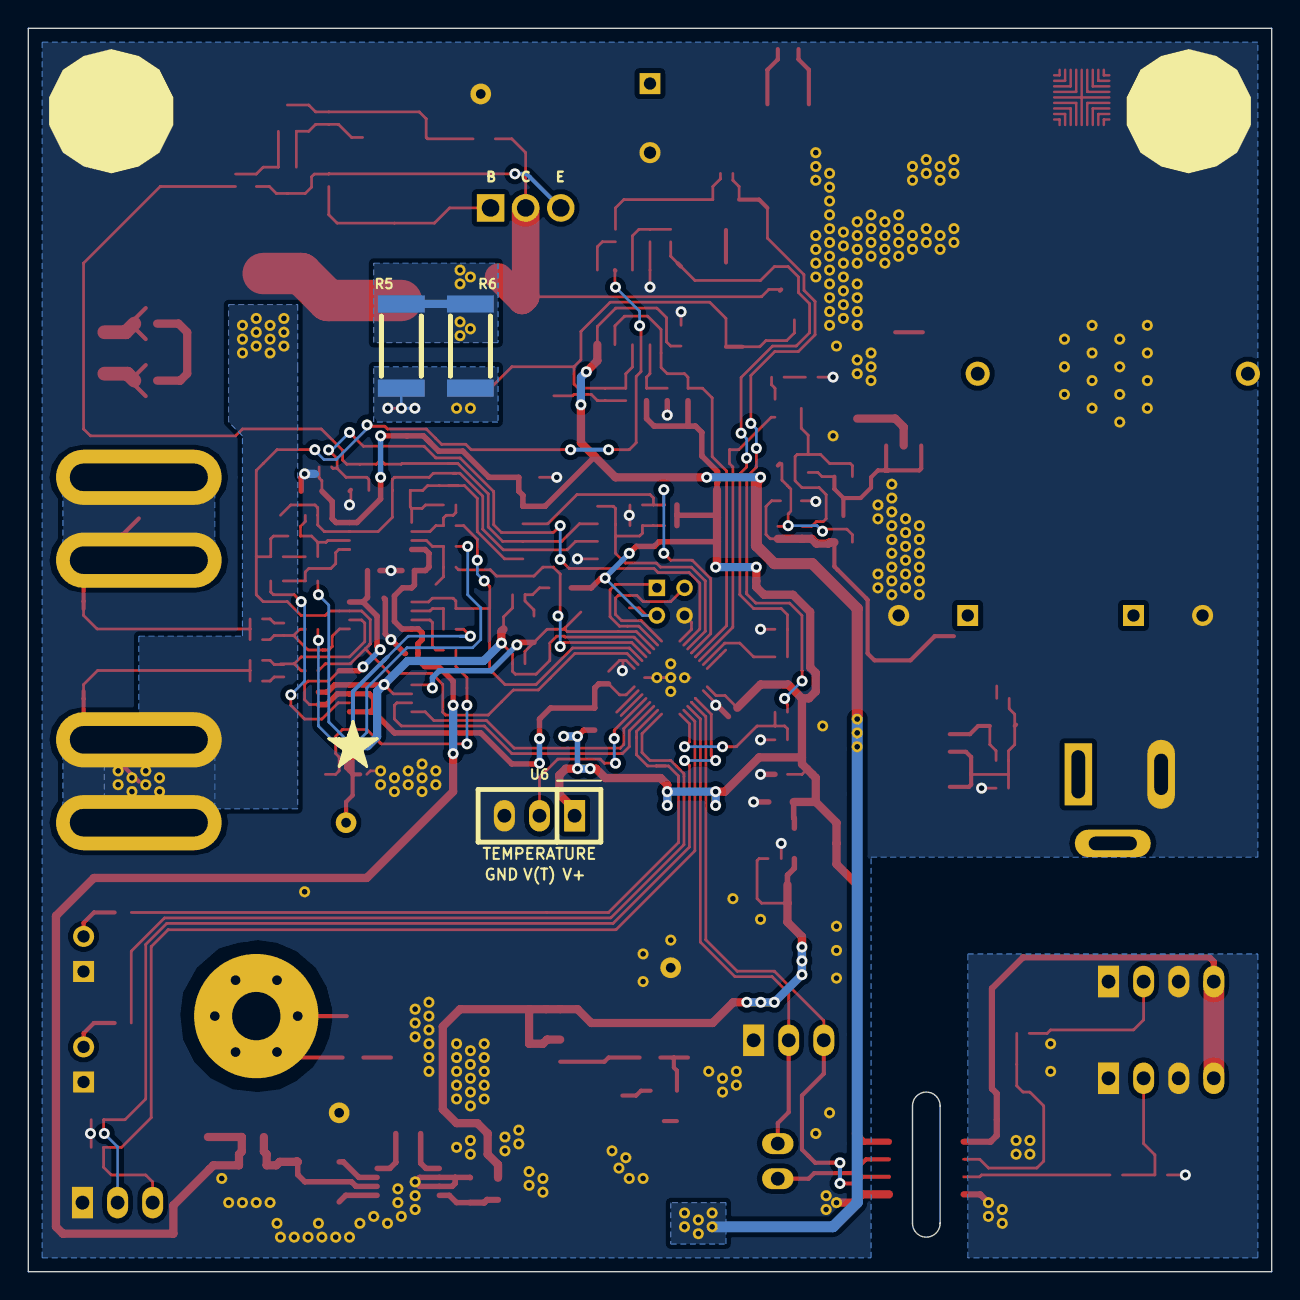
[picture p15: board mod12003.kicad_pcb from below]

Board: 2 copper layers, 90.0 x 90.0 mm, 281 parts (3 on the bottom side), 97 nets.

Parts:
C1, C55, C56: 1u; CAPC2012X70
C2, C17, C18, C25, C27, C29, C30: 22n; CAPC1005X55
C3, C19, C20, C21, C23, C31, C32, C33, C34, C35, C36, C37, C38, C39, C45, C47, C52, C53, C59: 100n; CAPC1005X55
C4: 330u; CAPAE1030X1250
C5, C6, C16: 470u; C-ALUM-10mm
C7, C40: 6u8; CAPC3216X70
C8, C9, C12, C14, C22, C24, C26, C41, C42: 100n; CAPC1608X55
C10, C28, C54, C57: 220p; CAPC1005X55
C11: 33u; CAPAE660X570
C13, C15: 1u; CAPC3225X88
C43, C44, C46, C49, C50: 4u7; CAPC2012X70
C48, C51: 22u; CAPC3216X70
C58: 1n/1kV; CAPC3216X70
D1: 40V/5A; TO-252
D2: MBRS360B; DIOM5436X244
D3, D4: BAT54AWT; SC-70
D5: MBR0530; SOD-123
DS1: CV; LED-5mm
DS2: CC; LED-5mm
DZ1: 84B24; SOT-23
E1, E2, E3, E4, E5, E6: 120; INDC1608X95
F1, F2, F3: 4A; RESC3216X60
J1: IN; CONN-100MIL-M-1x4-SHROUD
J2: OUT; CONN-100MIL-M-1x4-SHROUD
J3: 24V; CONN-PJ-037A
J4: OUT+; J1
J5: OUT-; J1
J6: PDI; CONN-100MIL-M-2x3
J7: BUTTONS; CONN-100MIL-M-1x3-SHROUD
J8: DEVEL; CONN-100MIL-M-1x3
JP1, JP2: JUMPER-SOLDER; JUMPER-SOLDER-3mm
JP3: JUMPER; CONN-100MIL-M-1x2
L1, L3, L4: 3u3; BOURNS-SRN5040
L2: 100u; L1
L5: 22u; BOURNS-SRN3015
MP1, MP2, MP3: SCREW; SCREW-4-SUPPORTED
Q1, Q7: AO4805; SOIC127P600X175-8
Q2: 12A; TO-252
Q3, Q4: 3904; SC-70
Q5, Q6: 4403; SC-70
Q8: 4403; SOT-23
Q9: 2N7002PW; SC-70
Q10: D45H11; TO-220
Q11: PMSS3904; SC-70
Q12: PZT3904; SOT-223
R1, R2, R34, R35, R38, R41, R52, R53: 470k; RESC1005X40
R3: R010; RESC3216X60
R4, R22, R32, R37, R44, R45: 348; RESC1005X40
R5, R6, R28: 1k; RESC6432X70
R7, R15, R16, R21, R23, R24, R25, R29, R30, R39, R42: 22k; RESC1005X40
R8, R9, R10, R13, R14, R17, R18, R19, R20, R26, R27, R31, R33, R36, R43, R46, R47, R49, R50: 2k; RESC1005X40
R11, R12, R40, R51: 100; RESC1005X40
R48: 6k98; RESC1005X40
TP1: PREREG; TEST-SMD-SMALL
TP2: 2V048; TEST-SMD-SMALL
TP3: 3V6; TEST-SMD-SMALL
TP4: 3V3; TEST-SMD-SMALL
TP5: -230mV; TEST-SMD-SMALL
TP6: OVP_TH; TEST-SMD-SMALL
TP7: VSENSE; TEST-SMD-SMALL
TP8: VSET; TEST-SMD-SMALL
TP9: ISENSE; TEST-SMD-SMALL
TP10: ISET; TEST-SMD-SMALL
TP11: VDRIVE; TEST-SMD-SMALL
TP12: IDRIVE; TEST-SMD-SMALL
TP13: DRIVE; TEST-SMD-SMALL
TP14: SW; TEST-SMD-SMALL
U1: OPA2376AIDGK; SOP65P490X110-8
U2: LM358DGK; SOP65P490X110-8
U3, U4: LM393M; SOIC127P600X175-8
U5: ATXMEGA32E5-M4U; QFN40P400X400X55-33
U6: MCP9701-E/TO; CONN-100MIL-M-1x3
U7: ADR380; SOT-23
U8: AOZ1282; SOT-23-6
U9: TLV70233DBV; SOT-23-5
U10: LM7705; SOP65P490X110-8
U11: MAX5215; SOP65P490X110-8
U12: Si8421; SOIC127P600X175-8
VIA5, VIA5#2, VIA5#3, VIA5#4, VIA5#5, VIA5#6, VIA11, VIA12, VIA21, VIA22, VIA32, VIA311, VIA312, VIA321, VIA322, VIA331, VIA331#2, VIA331#3, VIA3111, VIA3111#2, VIA3111#3, VIA3112, VIA3112#2, VIA3112#3, VIA3112#4, VIA3112#5, VIA3112#6, VIA3112#7, VIA3112#8, VIA3112#9, VIA3112#10, VIA3112#11, VIA3112#12, VIA3112#13, VIA3112#14, VIA3112#15, VIA3112#16, VIA3112#17, VIA3121, VIA3121#2, VIA3122, VIA3122#2, VIA3311, VIA3312, VIA3313, VIA3321, VIA3322, VIA3323, VIA3331, VIA3332, VIA3333, VIA33111, VIA33112, VIA33113, VIA33114, VIA33115, VIA33121, VIA33122, VIA33123, VIA33124, VIA33125, VIA33131, VIA33132, VIA33133, VIA33134, VIA33135, VIA33211, VIA33212, VIA33212#2, VIA33212#3, VIA33212#4, VIA33212#5, VIA33221, VIA33222, VIA33223, VIA33231, VIA33232, VIA33233, VIA33241, VIA33242, VIA33243, VIA331111, VIA331112, VIA331311, VIA331312, VIA331313, VIA331321, VIA331322, VIA331323, VIA331331, VIA331332, VIA331333: VIA-0.8mm
W1, W2, W3: NET-TIE; NET-TIE-0.3mm

Connections:
+3.3: C31.1, C50.1, C55.1, E2.1, E6.1, J6.2, R34.2, R35.2, R36.2, R38.2, R39.2, R50.1, TP4.1, U5.17, U6.1, U9.5, U12.8
+3.3A: C20.1, C32.1, C59.1, E2.2, U1.8, U5.32, U11.5, U11.7
+3.6: C45.1, C47.1, E3.2, E4.1, TP3.1, U9.1, U9.3
/Control/BTN1: C39.1, J7.2, U5.20
/Control/BTN2: C37.1, J7.3, U5.23
/Control/FORCE_SAT_L: C28.2, R25.1, R26.1, U2.6, U5.31
/Control/ISENSE: R21.2, R27.2, TP9.1, U1.1, U5.3
/Control/ISET: C38.1, R44.1, TP10.1, U2.3
/Control/LEDCC: R46.1, U5.25
/Control/LEDCV: R47.1, U5.26
/Control/OVPTH_PWM: R41.2, U5.15
/Control/OVP_THRESH: C35.1, R17.2, R41.1, TP6.1
/Control/PDI_C: J6.5, R39.1, U5.8
/Control/PDI_D: J6.1, U5.7
/Control/PREREG_SW: Q3.1, TP14.1, U5.14
/Control/RX: J8.2, JP3.2, U5.22
/Control/SCL: U5.27, U11.3
/Control/SDA: U5.28, U11.4
/Control/TEMP: U5.29, U6.2
/Control/VREF: C34.1, TP2.1, U5.6, U7.2, U11.1
/Control/VSENSE: C25.2, R19.1, R25.2, TP7.1, U1.7, U4.2, U5.2
/Control/VSET: C36.1, R45.1, TP8.1, U2.5
/Control/~EN: Q9.1, R29.1, U5.10
/Control/~ILIM: C30.2, R35.1, U3.7, U5.12
/Control/~SCR_TRIPPED: R38.1, U4.7, U5.13
/Control/~VLIM: C29.2, R34.1, U3.1, U5.11
/Iso/FROM_ISO_IN: JP3.1, U12.7
/Iso/ISO_5V: C56.1, J1.4, J2.4, U12.1
/Iso/ISO_GND: C54.1, C56.2, C57.1, J1.1, J1.3, J2.1, J2.3, U12.4, VIA3112.1, VIA3112#2.1, VIA3112#3.1, VIA3112#4.1, VIA3112#5.1, VIA3112#6.1, VIA3112#7.1, VIA3112#8.1, VIA3112#9.1, VIA3112#10.1
/Iso/ISO_IN: J1.2, R51.2
/Iso/ISO_OUT: C57.2, J2.2, R40.2
/Iso/TO_ISO_OUT: J8.3, U5.21, U12.6
/Linear/ISENSE: C3.2, C4.2, J5.1, Q2.1, R3.1, R4.1, R5.1, R6.1, R18.2, W3.2
/Linear/P_IN: C14.2, C15.1, C16.1, L4.1, Q8.2, Q10.3, R12.1, R23.2, R31.2, R42.1, TP1.1
/Linear/P_OUT: C4.1, DZ1.3, E1.1, F1.2, JP1.1, JP2.1, Q2.3, Q10.2, R5.2, R6.2, VIA5.1, VIA5#2.1, VIA5#3.1, VIA5#4.1, VIA5#5.1, VIA5#6.1
/Linear/SCR_FIRE: C3.1, DZ1.1, Q2.2, R4.2, R28.1, U4.6
/Linear/VSENSE+: R14.2, R16.2, W2.1
/Linear/VSENSE-: R13.2, R15.2, W3.1
/LocalPwr/3V6SW: C42.2, D5.1, L5.2, U8.6
/LocalPwr/3V6UF: C43.1, C44.1, E3.1, L5.1, R48.1
/LocalPwr/3V6_7705: C46.1, E4.2, U10.4
/LocalPwr/CF+: C49.2, U10.1
/LocalPwr/CF-: C49.1, U10.8
/OUT+: F1.1, F2.1, F3.1, J4.1, W2.2
/PAD_MP1: C58.1, MP1.1, R52.2
/Preregulator/PREF1: C11.1, L2.1, L3.2
/Preregulator/PREF2: C12.2, C13.1, L3.1, L4.2, R12.2
/Preregulator/SWNODE: D2.1, L2.2, Q7.5, Q7.6, Q7.7, Q7.8, R11.2
/Preregulator/V+F: C6.1, C7.1, C8.2, C9.2, L1.1, Q5.2, Q7.1, Q7.3, R7.1, R10.1
/VIN: J3.1, Q1.5, Q1.6
/VRP: C1.1, Q1.1, Q1.3, R2.2
GND: C5.2, C6.2, C7.2, C8.1, C9.1, C10.1, C11.2, C12.1, C13.2, C14.1, C15.2, C16.2, C19.2, C20.2, C21.2, C22.1, C23.2, C24.1, C26.1, C29.1, C30.1, C31.2, C32.2, C35.2, C37.2, C39.2, C40.2, C41.2, C43.2, C44.2, C45.2, C46.2, C47.2, C48.2, C50.2, C51.2, C52.2, C53.2, C55.2, C58.2, D2.2, D5.2, DS1.1, DS2.1, J3.2, J6.6, J7.1, J8.1, Q6.3, Q9.2, R1.1, R3.2, R9.2, R37.1, R43.2, R49.2, R50.2, R53.1, U3.4, U4.4, U5.1, U5.9, U5.18, U5.33, U6.3, U8.2, U9.2, U10.2, U10.3, U10.5, U12.5, VIA11.1, VIA12.1, VIA21.1, VIA22.1, VIA32.1, VIA311.1, VIA312.1, VIA321.1, VIA322.1, VIA331.1, VIA331#2.1, VIA331#3.1, VIA3111.1, VIA3111#2.1, VIA3111#3.1, VIA3112#11.1, VIA3112#12.1, VIA3112#13.1, VIA3112#14.1, VIA3112#15.1, VIA3112#16.1, VIA3112#17.1, VIA3121.1, VIA3121#2.1, VIA3122.1, VIA3122#2.1, VIA3311.1, VIA3312.1, VIA3313.1, VIA3321.1, VIA3322.1, VIA3323.1, VIA3331.1, VIA3332.1, VIA3333.1, VIA33111.1, VIA33112.1, VIA33113.1, VIA33114.1, VIA33115.1, VIA33121.1, VIA33122.1, VIA33123.1, VIA33124.1, VIA33125.1, VIA33131.1, VIA33132.1, VIA33133.1, VIA33134.1, VIA33135.1, VIA33211.1, VIA33212#2.1, VIA33212#3.1, VIA33212#4.1, VIA33212#5.1, VIA33221.1, VIA33222.1, VIA33223.1, VIA33231.1, VIA33232.1, VIA33233.1, VIA33241.1, VIA33242.1, VIA33243.1, VIA331111.1, VIA331112.1, VIA331311.1, VIA331312.1, VIA331313.1, VIA331321.1, VIA331322.1, VIA331323.1, VIA331331.1, VIA331332.1, VIA331333.1, W1.1
unnamed: C1.2, C2.2, Q1.2, Q1.4, R1.2, R2.1
unnamed: C10.2, R11.1
unnamed: C17.1, R15.1, R19.2, U1.6
unnamed: C17.2, R13.1
unnamed: C18.1, R16.1, R20.2, U1.5
unnamed: C18.2, R14.1
unnamed: C19.1, R17.1, U4.3
unnamed: C25.1, R26.2
unnamed: C27.1, D3.1, TP12.1, U2.1, U3.5
unnamed: C27.2, R27.1, U2.2
unnamed: C28.1, D3.2, TP11.1, U2.7, U3.3
unnamed: C33.1, E6.2, U7.1
unnamed: C42.1, U8.1
unnamed: C48.1, U10.7
unnamed: C51.1, C52.1, E5.1, U10.6
unnamed: C54.2, R51.1, U12.2
unnamed: D3.3, Q9.3, R32.1, TP13.1, U3.2, U3.6
unnamed: D4.1, Q11.2, Q12.1, R33.2
unnamed: D4.2, Q11.1, R30.1, R32.2
unnamed: D4.3, E1.2, Q12.3, R33.1
unnamed: DS1.2, R46.2
unnamed: DS2.2, R47.2
unnamed: F2.2, JP1.2
unnamed: F3.2, JP2.2
unnamed: Q3.2, R8.1
unnamed: Q3.3, Q4.1, Q6.1, R7.2
unnamed: Q4.2, Q5.3, Q6.2, Q7.2, Q7.4
unnamed: Q4.3, Q5.1, R10.2
unnamed: Q8.1, R23.1, R24.2
unnamed: Q8.3, R28.2
unnamed: Q10.1, Q12.4, R31.1
unnamed: R8.2, R9.1
unnamed: R18.1, U1.3
unnamed: R21.1, R22.2, U1.2
unnamed: R24.1, U4.1
unnamed: R36.1, R37.2, U4.5
unnamed: R40.1, U12.3
unnamed: R42.2, R43.1, U5.24
unnamed: R44.2, U5.4
unnamed: R45.2, U11.6
unnamed: R48.2, R49.1, U8.3
unnamed: R52.1, R53.2
REFGND: C33.2, C34.2, C36.2, C38.2, C59.2, R20.1, R22.1, U5.5, U7.3, U11.2, U11.8, VIA33212.1, W1.2
V+: C2.1, C5.1, C22.2, C24.2, C26.2, C40.1, C41.1, L1.2, Q1.7, Q1.8, Q11.3, R29.2, R30.2, U2.8, U3.8, U4.8, U8.4, U8.5
V-: C21.1, C23.1, C53.1, E5.2, TP5.1, U1.4, U2.4
