semianalog/mod12003/fw/misc_math.h

#ifndef _MISC_MATH_H
#define _MISC_MATH_H

#include <inttypes.h>
#include <util/atomic.h>

#define NOINLINE    __attribute__((noinline))
#define PURE        __attribute__((pure))

static const int64_t    LINEAR_DENOM    = 65536;

/**
 * Linear function. Find y, where y = mx + b.
 *
 * Out-of-range results are clamped to 0 and UINT16_MAX.
 */
uint16_t linear(int32_t m_numer, uint16_t x, int16_t b) NOINLINE PURE;

/**
 * Lightweight u16-to-string routine.
 *
 * @param str - string buffer, must have at least six bytes
 * @param num - number to convert
 */
void u16_to_str(char *s, uint16_t num);

/**
 * Atomic access macro. Accesses the given variable in an ATOMIC_BLOCK(ATOMIC_RESTORESTATE)
 * and returns the value.
 */
#define ATOMIC_ACCESS(v) ({ typeof(v) __temp; ATOMIC_BLOCK(ATOMIC_RESTORESTATE){ __temp = (v); } __temp; })

#endif // _MISC_MATH_H
