semianalog/mod12003/fw/timers.h

#ifndef _TIMERS_H
#define _TIMERS_H

#include <inttypes.h>
#include <stdbool.h>

extern volatile bool TICK;

void timers_init(void);

#define PWM_TOP UINT8_MAX

void timer_pwmset_ovpth(uint8_t n);
void timer_pwmset_prereg(uint8_t n);

#endif // _TIMERS_H
