semianalog/mod12003/(commit log)

2015-08-19 First working version
    [Control.sch, Iso.sch, Linear.sch, LocalPwr.sch, Preregulator.sch, modpsu.kicad_pcb, modpsu.sch]
2015-08-19 Reannotate component references
    [Control.sch, Iso.sch, Linear.sch, LocalPwr.sch, Preregulator.sch, modpsu.kicad_pcb, modpsu.sch]
2015-08-29 Piles and piles of work
    [Control.sch, Iso.sch, Linear.sch, LocalPwr.sch, Preregulator.sch, modpsu.kicad_pcb, modpsu.sch]
2015-08-29 Rename project from modpsu to mod12003
    [Control.sch, Iso.sch, Linear.sch, LocalPwr.sch, Preregulator.sch, mod12003.kicad_pcb, mod12003.sch]
2015-08-29 Remove OSHW logo
    [mod12003.kicad_pcb, mod12003.sch]
2015-08-29 Documentation editing
    [Control.sch, Iso.sch, Linear.sch, LocalPwr.sch, Preregulator.sch, mod12003.sch]
2015-09-21 Finish PCB
    [Control.sch, Iso.sch, Linear.sch, LocalPwr.sch, Preregulator.sch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]
2015-09-27 Switch to single-byte command
2015-09-29 Add bit-banged I2C master
2015-09-29 Add I2C DAC
2015-11-02 Switch to C11
2015-11-02 Add simple calibration
2015-11-02 Adjust calibration points for better accuracy
2015-11-02 Set PSU output voltage using calibration
2015-11-02 Add voltage monitoring and reporting
2015-11-02 Add voltage control loop
2015-11-02 Remove branding from schematic (may re-add later)
    [mod12003.sch]
2015-11-03 Fix regression in prereg control
    [psu.c]
2015-11-03 Remove TODO comment
    No, resetting the accumlator cannot be skipped. Recovery time is too
    long.
    [psu.c]
2015-11-03 Set preregulator before calibration
2015-11-03 Add LEDs and mode reporting
    [Control.sch]
2015-11-03 Add output enable (known bug!)
    Bug: output voltage blips to about 5.4V at enable.
    [loop_handlers.c, main.c, psu.c]
2015-11-03 Fix output blip
    Add a bodge wire to prototype to allow the MCU to force the regulator
    into saturation-low
    [Control.sch, Linear.sch, mod12003.sch]
2015-11-03 Add current control
2015-11-03 Rework calibration
2015-11-03 Fix typo in comment
    [loop.h]
2015-11-03 Replace sprintf to reduce code size
    [loop_handlers.c, misc_math.c, misc_math.h]
2015-11-04 Add temperature sense and debug info command
2015-11-04 Tweak control loop windup prevention
    [analog.h, psu.c]
2015-11-04 Reset integrator whenever not integrating
    [psu.c]
2015-11-04 Initial power dissipation measurement (buggy)
    [loop_handlers.c, misc_math.h, psu.c, psu.h]
2015-11-04 Interrupt-safety fixes
2015-11-13 Add PSRR improvement
    [Linear.sch]
2015-11-17 Update branding
    [Control.sch, Iso.sch, Linear.sch, LocalPwr.sch, Preregulator.sch, mod12003.kicad_pcb, mod12003.sch]
2015-11-17 Revise schematic
    [Iso.sch, mod12003.sch]
2016-01-17 Sch library updates
    [Control.sch, Iso.sch, Linear.sch, LocalPwr.sch, Preregulator.sch, mod12003.sch]
2016-01-17 Switch programmer
2016-01-17 Fix disable logic: only call once
    [psu.c]
2016-01-17 Make sure preregulator starts switched off
2016-01-17 Factor out voltage_integrator_cycle()
2016-01-17 Remove VOLTAGE_LOOP_SKIPS
2016-01-18 Add KiCad libraries as submodules
2016-01-18 Update schematic to new symbols
    [Control.sch, Iso.sch, Linear.sch, LocalPwr.sch, Preregulator.sch, mod12003.kicad_pcb, mod12003.sch]
